j1rie/IRMP_STM32/RP2xxx/LIESMICH.md

## IRMP auf RP2xxx

RP2040-One+TSOP [1]  
IR-Sensor_1
IR-Sensor_2 [2]  

Für Boards mit dem RP2xxx, z.B. den Raspberry Pi Pico, Pico2 und viele andere.  
Dies sind zusätzliche Informationen, grundlegende Informationen unter https://github.com/j1rie/IRMP_STM32/blob/master/LIESMICH.md.

## Firmware flashen
USB Verbindung trennen.
Halten Sie die BOOTSEL-Taste gedrückt und steckenn Sie das Gerät an den USB Anschluss. Das Gerät wird als Massenspeicher angezeigt (USB ID 2e8a:0003).  
Ziehen Sie die Datei firmware.uf2 per Drag & Drop auf den Massenspeicher. Das Gerät wird neu gestartet und startet als IRMP HID Gerät.

Durch das Senden des Befehls „reboot“ wird das Gerät ebenfalls in den Massenspeichermodus versetzt.

Wenn sich bereits eine ältere Firmware auf dem Gerät befindet, versetzt stm32IRconfig - b das Gerät in den Massenspeichermodus, und
picotool load -v -x firmware.uf2 flasht die Firmware, verifiziert und startet sie.

## Motherboard Test
Wenn einer der Einschaltpins an Masse liegt und der andere ca. +3,3 V oder +5 V führt, ist das Motherboard für die folgende einfache Verkabelung geeignet.  
Wenn nicht (sehr selten) braucht man einen Optokoppler.

## Kabel löten und anschließen
Ein 10 cm Dupont-Kabel wird aufgetrennt, die beiden Enden miteinander und dem 220 Ohm Widerstand verbunden, das andere Ende des Widerstands wird mit einem 20 cm Dupont-Kabel, dessen eine Buchse abgeschnitten ist, verbunden. Lötstellen einschrumpfen und das zweite 10 cm Kabel mittels Schrumpfschlauch anheften.  
Der TSOP wird direkt mit den Pins 3,3 V, GND und IR_IN verbunden, das Kabelpaar wird zwischen die Mainboard-Einschaltpins und den Stecker des Einschalters eingeschleift.  

Kabel
verbunden

## Erster Test
Wenn man im Suspend-Modus die BOOTSEL-Taste drückt, sollte der PC aufwachen.

## Emuliertes Eeprom
Jede Konfiguration, die mit einem der Konfigurationsprogramme vorgenommen wird, wird zunächst nur im Cache gespeichert. Um
diese Änderungen dauerhaft im Flash zu speichern, muss ein Eeprom-Commit durchgeführt werden. Dies betrifft Makros und mehrere Wakeups.  
Ausnahme: Der erste wakeup wird aus Gründen der Abwärtskompatibilität von der Firmware übertragen.

## Aus den Quellen bauen
Siehe [Getting Started with the Raspberry Pi Pico](https://rptl.io/pico-get-started)  
-> SDK und die Beispiele herunterladen  
-> Toolchain Installieren  
-> „Blink“ erstellen  
-> „Blink“ hochladen und ausführen  

## Pin-Out
Siehe ./src/config.h.

## 5 V vom Netzteil statt über USB
Wenn das Gerät vom Netzteil versorgt werden muss, darf es nicht zusätzlich über USB versorgt werden, um Querströme zu vermeiden.
Eine Möglichkeit ist es, die Leiterbahn auf dem PCB zu durchtrennen:  

VBUS trennen

## Signale von den LEDs
Der Pico(2) hat eine normale LED, der One und der Zero haben eine RGB LED, und der XIAO-RP2350 hat eine Duale und eine RGBW LED.  
Zusätzlich kann eine externe LED oder externe RGB LED (WS2812 oder APA106) angeschlossen werden.  
Diese zeigen an, was in der Firmware passiert.  
Dann gibt es noch die Status LED (über hidraw angesteuert), die den Status des vdr-plugin-statusleds2irmplirc anzeigt (und beim Einschalten, beim Speichern des ersten Wakeups und bei Reboot blinkt).

| Empfänger |  Board/Externe RGB-LED | Board/Externe LED  | Externe Status-LED |
|---|---|---|---|
| stromlos |  aus | | |
| USB eingehängt |  weiß (oder custom) | | |
| USB suspend |  orange | | |
| IR Empfang |  flackert blau | flackert | |
| Wakeup speichern |  blinkt schnell rot | blinkt schnell | blinkt schnell |
| Wakeup |  blinkt schnell rot | blinkt schnell | blinkt schnell |
| Reboot |  blinkt schnell rot | blinkt schnell | blinkt schnell |
| IR senden |  kurz gelb | kurz an | |
| VDR läuft |  rot(*) | | an(*) |
| VDR nimmt auf |  blinkt rot entsprechend Anzahl Aufnahmen(*) | | blinkt entsprechend Anzahl Aufnahmen(*) |
| Konfigurationsbefehl  |  kurz grün | kurz an | |
| firmware upgrade | | kurz an | kurz an |

(*) mit vdr-plugin-statusleds2irmplirc

## Externe RGB-LEDs
Es wird empfohlen, zwei Widerstände im Datenkabel zu verwenden, siehe http://stefanfrings.de/ws2812/.

##
 \
[1] Waveshare RP2040-One mit TSOP von clausmuus, siehe https://www.vdr-portal.de/forum/index.php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  
[2] Waveshare RP2040-One mit TSOP von FireFly, siehe https://www.vdr-portal.de/forum/index.php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
