j1rie/IRMP_STM32/stm32IRstatusled/README

Set statusled on STM32.
For use in vdr-plugin-statusleds.

Usage:
stm32IRstatusled [-d device] -s led_state

Examples:
switch the statusled on:  stm32IRstatusled -d /dev/hidraw1 -s 1
switch the statusled off: stm32IRstatusled -d /dev/hidraw1 -s 0

put the udev rule from irmplircd into your udev rules directory, then you don't need to give a device

vdr + vdr-plugin-statusleds + stm32IRstatusled:
vdr -P'statusleds --stm32IRstatusled_path=/path/to/stm32IRstatusled'
this will turn the led on, when vdr starts; it will turn the led off, when vdr stops; it will make the led blink during recording
for systemd add a line to the vdr service ExecStop=/path/to/stm32IRstatusled -s 0
