j1rie/IRMP_STM32/doc/README

These are copies of [1], [2] and [3], and those may be more up-to-date.
[1] https://www.mikrocontroller.net/articles/IRMP_auf_STM32_-_ein_USB_IR_Empf%C3%A4nger/Sender/Einschalter_mit_Wakeup-Timer
[2] https://www.mikrocontroller.net/articles/IRMP_auf_STM32_-_Bauanleitung
[3] https://www.mikrocontroller.net/articles/IRMP_auf_STM32_%E2%80%93_stark_vereinfachte_Bauanleitung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
