j1rie/IRMP_STM32/stm32IRconfig/Windows/README

configure and monitor IRMP_STM32

program and read the eeprom (wakeups, macros and capabilities)
reset wakeups, macros, alarm and eeprom
set and get the alarm
reboot the device
send IR
monitor (read) IRMP_STM32, stop with ^C
