j1rie/IRMP_STM32/irmplircd/Gentoo/README

Gentoo integration see https://www.vdr-portal.de/forum/thread/123572-irmp-auf-stm32-ein-usb-ir-empf%C3%A4nger-sender-einschalter-mit-wakeup-timer/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
