j1rie/IRMP_STM32/stm32FWupgrade/Linux/README

IRMP STM32 Firmware Upgrade Utility

very simple tool
in case of problems try dfu-util

disconnect device
run ./stm32FWupgrade ./firmwarefile.bin
connect device

for Windows WinUSB drivers from zadig are needed (see binaries/bootloader/Windows)
