j1rie/IRMP_STM32/vdr-plugin-irmplirc/LIESMICH

Dies ist ein Plugin fuer den Video Disk Recorder (VDR).

Verfasst von:                      Joerg Riechardt <J.Riechardt@gmx.de>

Projekt-Homepage:                  https://github.com/j1rie/IRMP_STM32_KBD/vdr-plugin-irmphidkbd

Aktuelle Version verfuegbar unter: https://github.com/j1rie/IRMP_STM32_KBD/vdr-plugin-irmphidkbd

Beschreibung: Das Plugin irmplirc sendet Tastatureingaben von einem IRMP HID-Geraet an VDR.

Die einfachste Methode zum Erstellen von Tastenbelegungen in remote.conf ist die Verwendung des Tasten-Anlernprozesses von VDR.

irmplircd wird dann nicht mehr gebraucht.

Wenn man das vdr-plugin-softhddevice verwendet, muss die Fernbedienungsfunktion von softhddevice mit -P'softhddevice ... -N' deaktiviert werden.
