j1rie/IRMP_STM32/vdr-plugin-irmplirc/README

This is a "plugin" for the Video Disk Recorder (VDR).

Written by:                  Joerg Riechardt <J.Riechardt@gmx.de>

Project's homepage:          https://github.com/j1rie/IRMP_STM32/vdr-plugin-irmplirc

Latest version available at: https://github.com/j1rie/IRMP_STM32/vdr-plugin-irmplirc

Description: The 'irmplirc' plugin sends keypresses from a IRMP HID-Device to VDR.

The easiest way for creating key mappings in remote.conf is to use VDR's key learning process.

Than irmplircd is not needed any more.

If you use the vdr-plugin-softhddevice, you need to disable softhddevice's remote control function with -P'softhddevice ... -N'.
