j1rie/IRMP_STM32/hardware/Black_jr5_bot.png

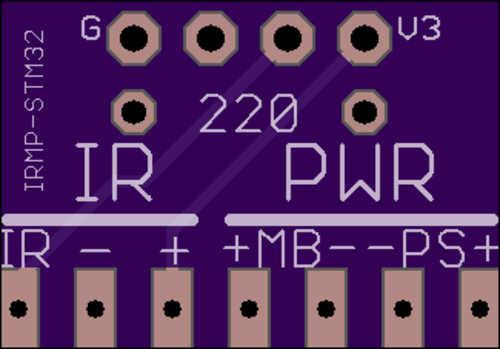
hardware/Black_jr5_bot.png
