j1rie/IRMP_STM32/hardware/Black_OC_jr7_bot.png

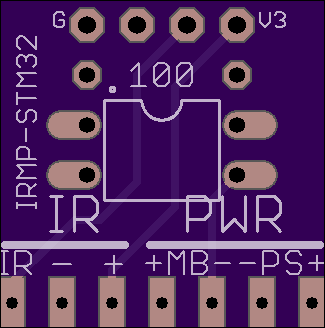
hardware/Black_OC_jr7_bot.png
