j1rie/IRMP_STM32/hardware/Maple_Mini_jr1_bot.png

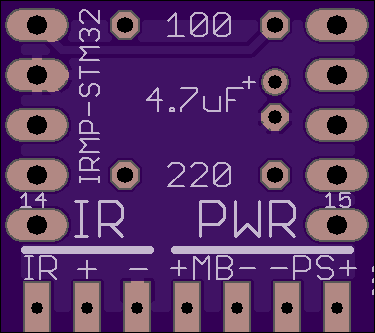
hardware/Maple_Mini_jr1_bot.png
