j1rie/IRMP_STM32/hardware/Maple_Mini_jr1_top.png

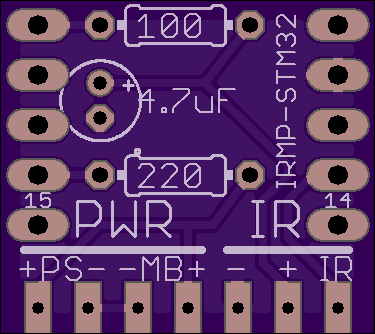
hardware/Maple_Mini_jr1_top.png
