j1rie/IRMP_STM32/hardware/Stick1_jr1_top.png

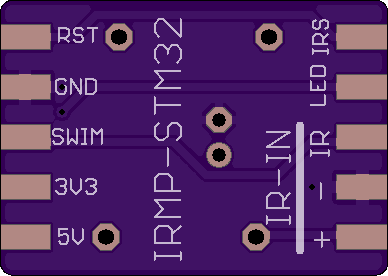
hardware/Stick1_jr1_top.png
