j1rie/IRMP_STM32/hardware/TSOP_jr3_bot.png

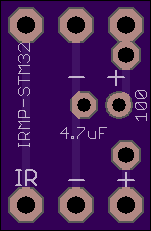
hardware/TSOP_jr3_bot.png
