j1rie/IRMP_STM32/hardware/TSOP_jr3_top.png

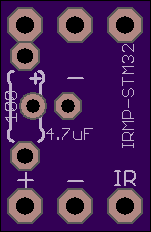
hardware/TSOP_jr3_top.png
