j1rie/IRMP_STM32/hardware/Verbinder_jr1_bot.png

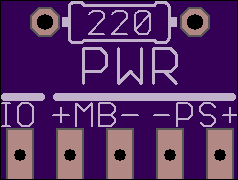
hardware/Verbinder_jr1_bot.png
