j1rie/IRMP_STM32/hardware/Verbinder_jr1_top.png

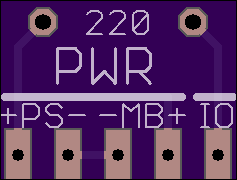
hardware/Verbinder_jr1_top.png
