j1rie/IRMP_STM32/doc/IRMP on STM32 - Construction manual.pdf

## IRMP on STM32 - Construction manual

Copyright (C) 2014-2015 Jörg Riechardt

## Contents

- 17 IRMP on STM32 - Construction manual
- 18 Foreword
- 19 Buy
- 20 Firmware Compilation (Linux)
- 21 Firmware Compilation (Windows)
- 22 Programmer
- 23 Target
- 24 Flashing (Linux)
- 25 Flashing (Windows)
- 26 Connections
- 27 Learning Wakeup
- 28 Testing (Linux)
- 29 Testing (Windows)
- 30 Expansion Board
- 31 Bootloader (Linux)
- 32 Automatic Start/Stop of irmplircd(*) on Re/Disconnect with systemd
- 33 Minimalistic assembly for experienced users

## Foreword

This manual is for two ST-Links. You could use a developer board and a USB-serial-TTL adapter instead. The ST-Links in USB stick cases are wired like red ST-Links.

## Buy

You need two ST-Link V2 emulators.
An ebay search for "ST-Link V2 emulator" shows, what is available.
I bought the red one from seller e_goto for 4.99 $, so ca. 4 €.
The blue ones you get at http://www.aliexpress.com/item/STLINK-V2-STM8-STM32-emulator-programmer-mini-STLINK-downloader/1446941850.html

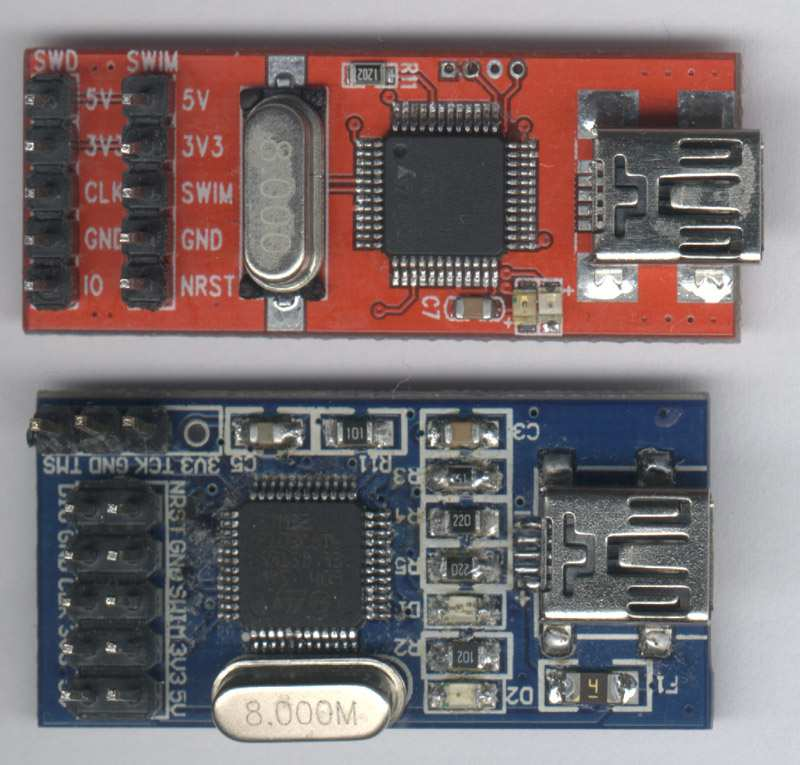
[picture p27: figure]

There are three pins soldered into the blue one for TCK and TMS.
On the blue one CLK and TCK and also DIO and TMS are exchanged.

## Firmware Compilation (Linux)

gcc-arm-none-eabi is needed for compilation. If it is not already available through your distribution, you can get it from https://launchpad.net/gcc-arm-embedded/+download .
git clone git://github.com/j1rie/IRMP_STM32.git IRMP_STM32
cd IRMP_STM32
cd F103
./make

## Firmware Compilation (Windows)

https://github.com/j1rie/IRMP_STM32
download and extract IRMP_STM32-master.zip
run prepare.bat in scripts
open IR.coproj in CooCox and compile

## Programmer

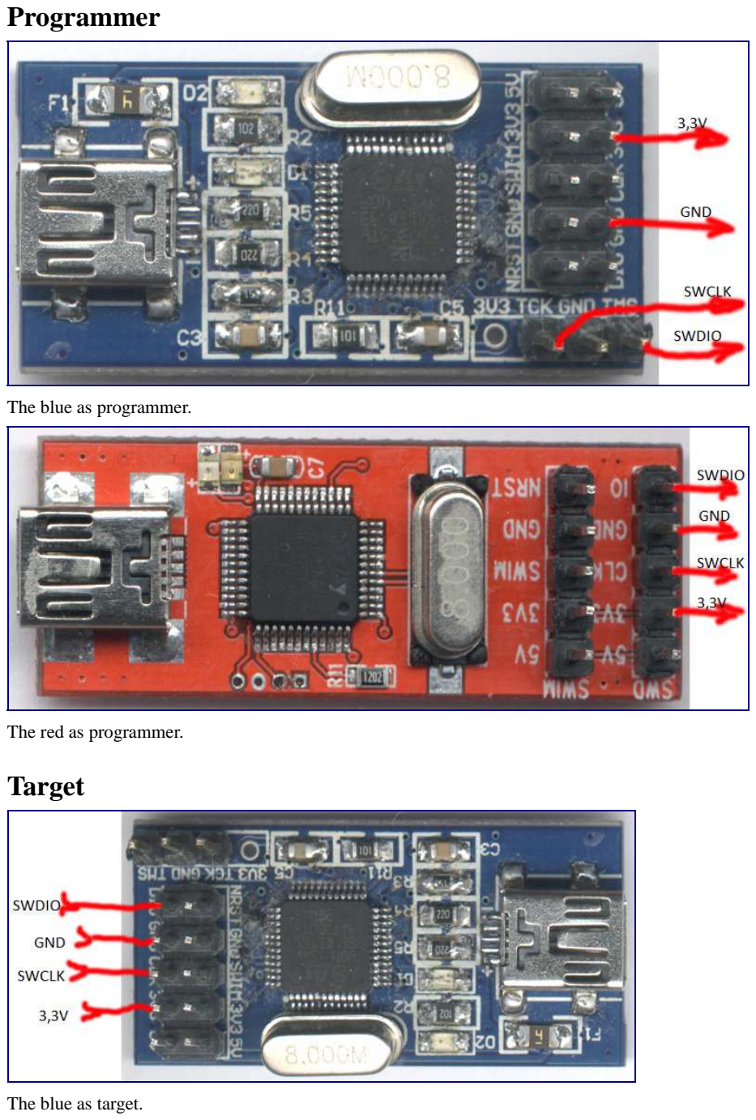
[picture p28: page 3]

The blue as programmer.

The red as programmer.

## Target

The blue as target.

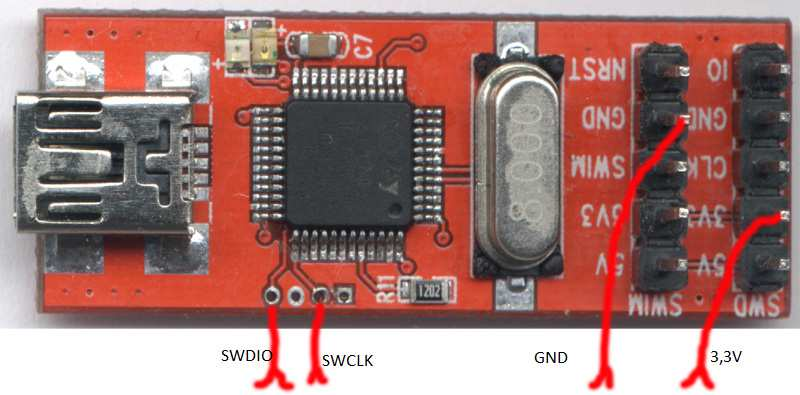
[picture p29: figure]

The red as target.
For the TSOP to work on SWIM, it might be necessary to remove the pullup on SWIM (image below). I have a (very old) TSOP, which does not work with the pullup. But a TSOP 34136 works even with the resistor.

With a red as programmer and a blue as target, you don't need to solder (if you go without the bootloader). Or you could simply press two contact pins against SWDIO und SWCLK during flashing.

## Flashing (Linux)

Connect programmer and target, SWCLK - SWCLK, SWDIO - SWDIO, 3,3V - 3,3V, Gnd -Gnd. You need to unlock the controller before the first flash with an openocd command:
$ openocd -f interface/stlink-v2.cfg -f target/stm32f1x_stlink.cfg -c "init" -c "halt" -c "stm32f1x unlock 0" -c "shutdown"
Then flash the firmware:
git clone git://github.com/texane/stlink.git
cd stlink
./autogen.sh
./configure
./make
./st-flash erase
./st-flash --reset write /IRMP_STM32/F103C8/firmware.bin 0x8000000
In some cases it is necessary, to reset the ST-Link at the beginning of flashing. You need to pull the marked area in the image to ground and release it shortly after the flash command.

## Flashing (Windows)

With the STM32 ST-LINK utility.
Connection and reset as in linux section.
Unlocking: -> Target -> Option Bytes, put Read Out Protection to Disabled. Flashen: -> Target -> Program & Verify

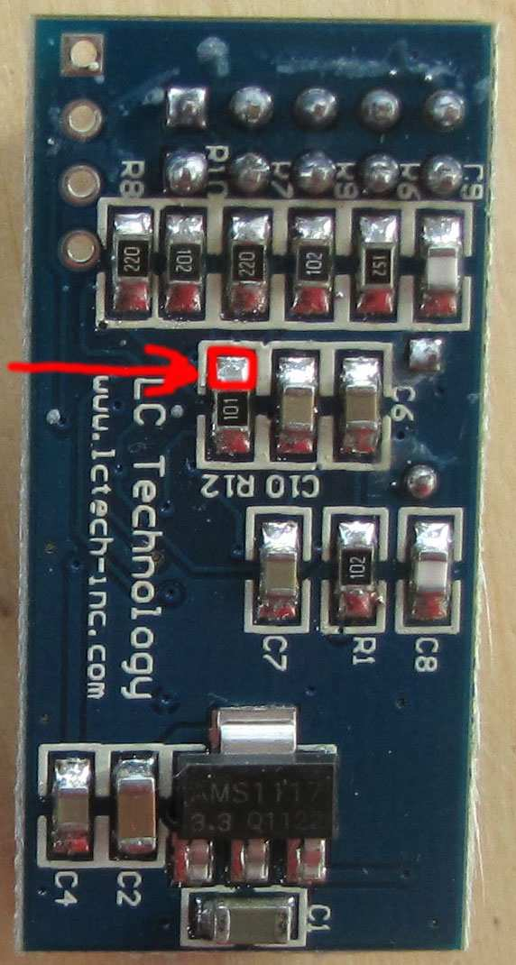
[picture p30: figure]

For reset pull the red marked to ground.

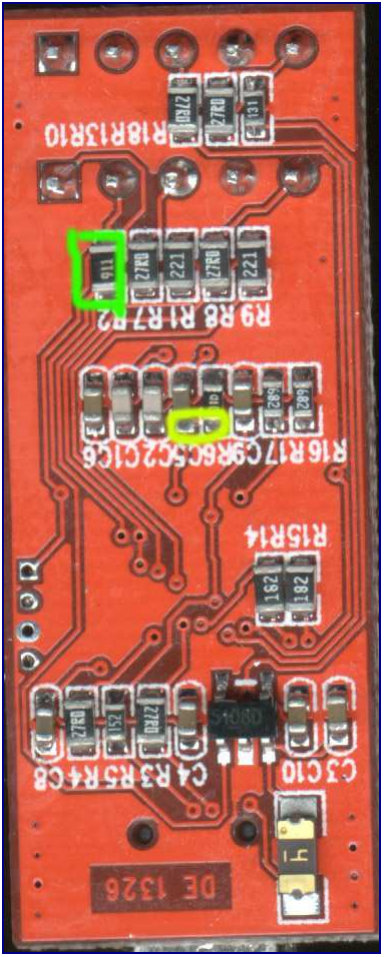
[picture p31: figure]

For reset pull the yellow marked to ground. Green marked the pullup on SWIM.

## Connections

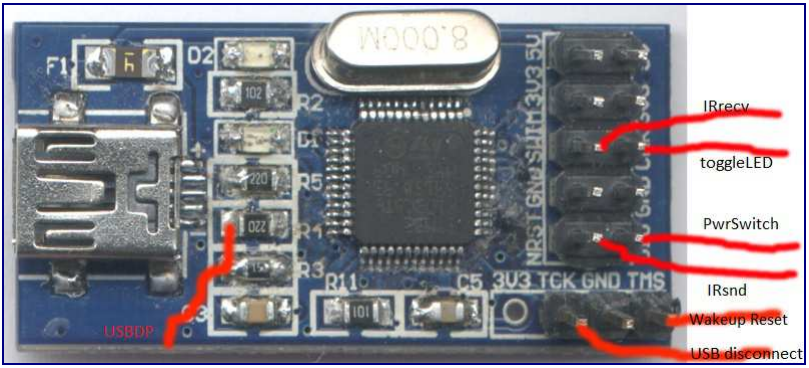
[picture p32: figure]

Connect the blue.

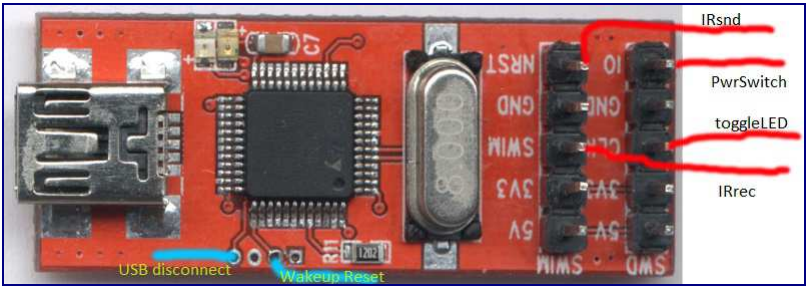
[picture p33: figure]

Connect the red.

## Learning Wakeup

If the first wakeup is empty, the first received IR data will be stored into the first wakeup.
To renew learning pull the wakeup reset pin shortly to ground and push within the next 5 seconds the button, which shall be learned.
You could enter the new wakeup IR data as well manually or via remote control with the configuration program.
If the PC is powered on, the wakeup button does not trigger the optocoupler, but is passed on by irmplircd. If the wakeup button has been trained in VDR as power button, you can power down the PC by it.

## Testing (Linux)

With stm32IRconfig_gui: connect the ST-Link, start stm32IRconfig_gui, press "receive mode" and test.
With stm32IRconfig: connect the ST-Link, start stm32IRconfig, enter m for monitor mode and test. With irmplircd: connect the ST-Link, start irmplircd and irw and test.

Please note: The (D)IO/PwrSwitch-pin switches only, if the PC is powered off.

## Testing (Windows)

With stm32IRconfig_gui: connect the ST-Link, start stm32IRconfig_gui, press "receive mode" and test.
With stm32IRconfig: connect the ST-Link, start stm32IRconfig, enter m for monitor mode and test. With SimpleHIDWrite: connect the ST-Link and select it in SimpleHIDWrite and test. http://janaxelson.com/hidpage.htm#tools
Please note: The (D)IO/PwrSwitch-pin switches only, if the PC is powered off.

## Expansion Board

There is a expansion board. With the connector on one side, it fits onto the blue, and with the connector on the other side it fits onto the red.
Circuit
http://www.vdr-portal.de/board73-marktplatz/board75-verkaufen/p1220193-usb-ir-receiver-inkl-einschalter-opensource-sw-hw/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
It is important, to pay attention to the polarity of the optocoupler. Those contacts, that are closer to IRin, are plus.

## Bootloader (Linux)

git clone -b unify_platforms git://github.com/j1rie/maple-bootloader.git cd maple-bootloader
make Platform=Dev (Developer board) or
make Platform=Red (Red) or
make PPlatform=Blue (Blue)
Then flash ./build/maple_boot.bin.
After that you flash like this:
First run /path/FlashDFUSe.sh /path/newFirmware.bin*, then connect the ST-Link.
(*) The firmware needs to be compiled with Bootloader=1.

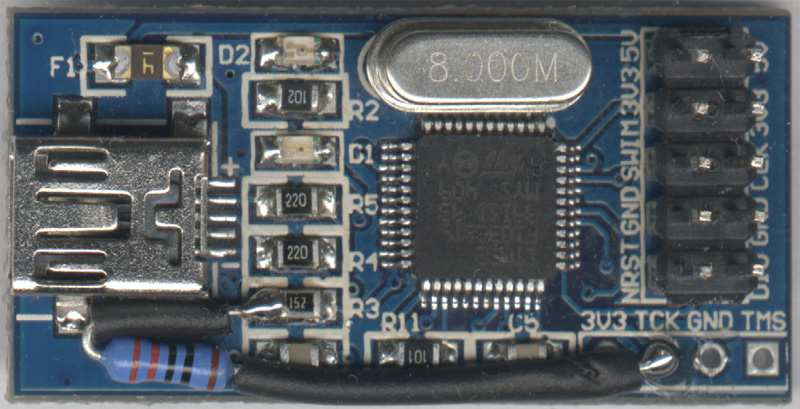
[picture p34: figure]

The blue with pulldown resistor between USBDP and USB disconnect pin.

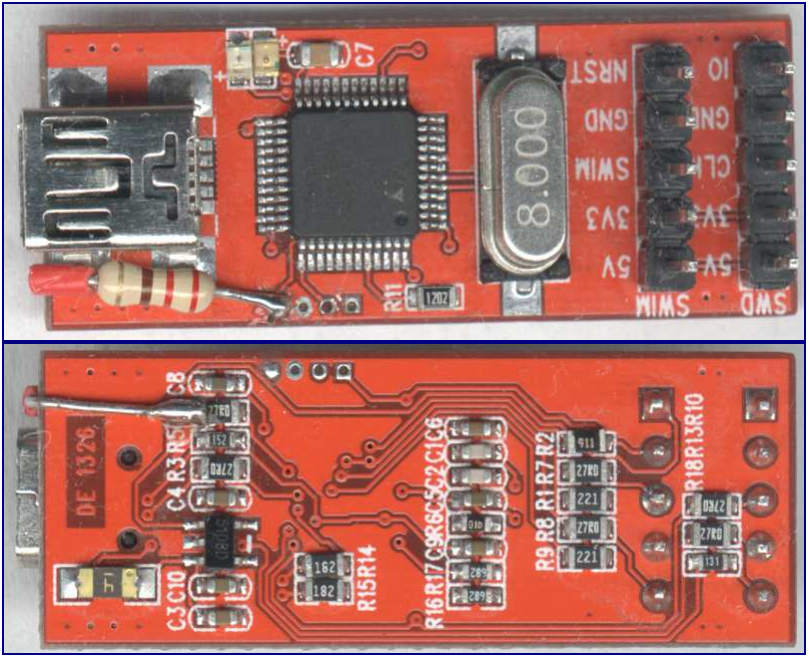
[picture p35: figure]

The red with pulldown resistor between USBDP and USB disconnect pin.

## Automatic Start/Stop of irmplircd(*) on Re/Disconnect with systemd

Copy 80-irmp.rules from IRMP_STM32/irmplircd/ to /etc/udev/rules.d/ .
Copy irmplircd.service from IRMP_STM32/irmplircd/ to /etc/systemd/system/ .
Activate service by 'systemctl enable irmplircd.service'.
Adapt paths to irmplircd and irmp_stm32.map in irmplircd.service if needed.
The translation tabelle irmp_stm32.map can be created and adapted with stm32IRconfig_gui. (*) https://github.com/realglotzi/irmplircd

## Minimalistic assembly for experienced users

Only for IR reception and turning the PC on. The TSOP is directly connected to the corresponding pins and the mainboard's active power switch pin is pulled down via the resistor (220 ohms) (SimpleCircuit = 1).
Please be careful and don't damage your motherboard!
Either directly via the protection resistor to the powerswitch-cable ...

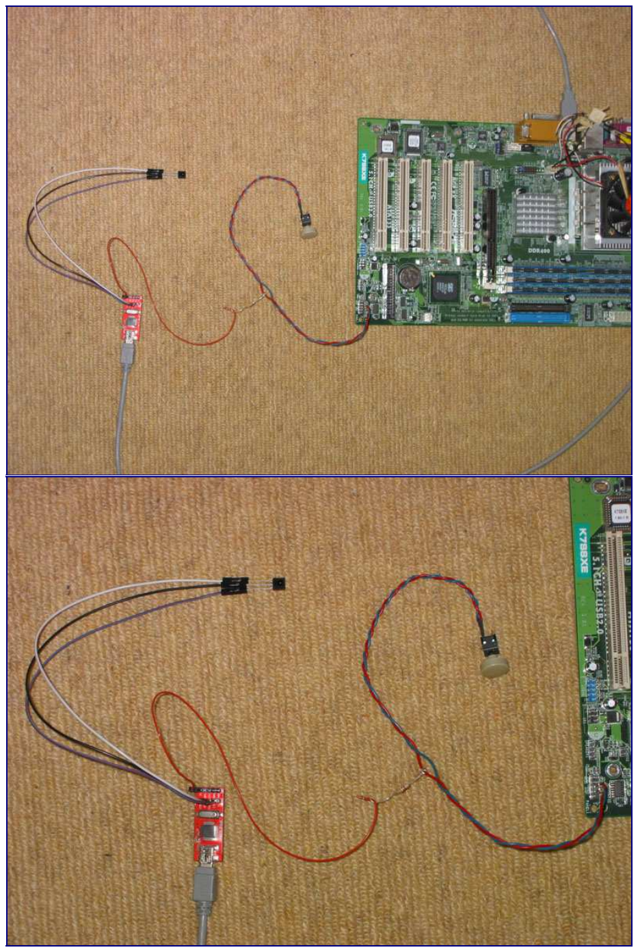
[picture p36: page 10]

… or to an inbetween piece, which gets inserted between board and powerswitch-cable.

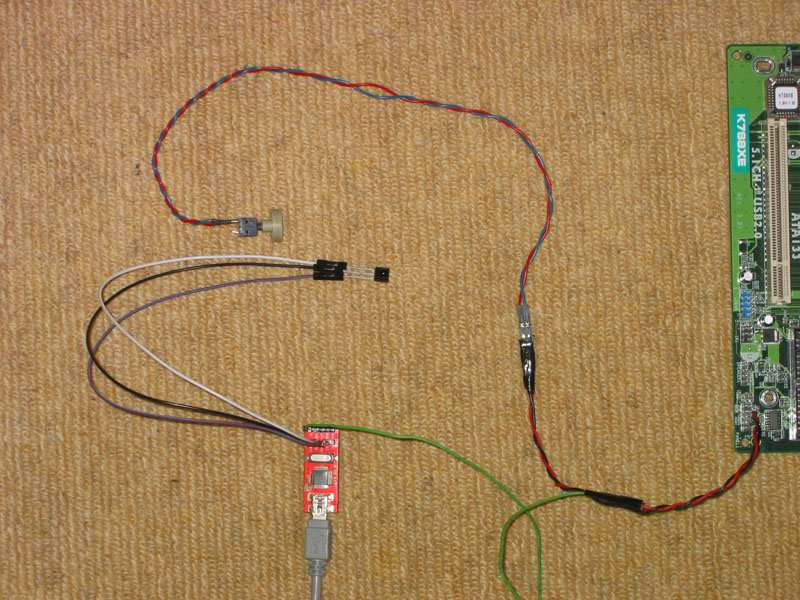
[picture p37: figure]

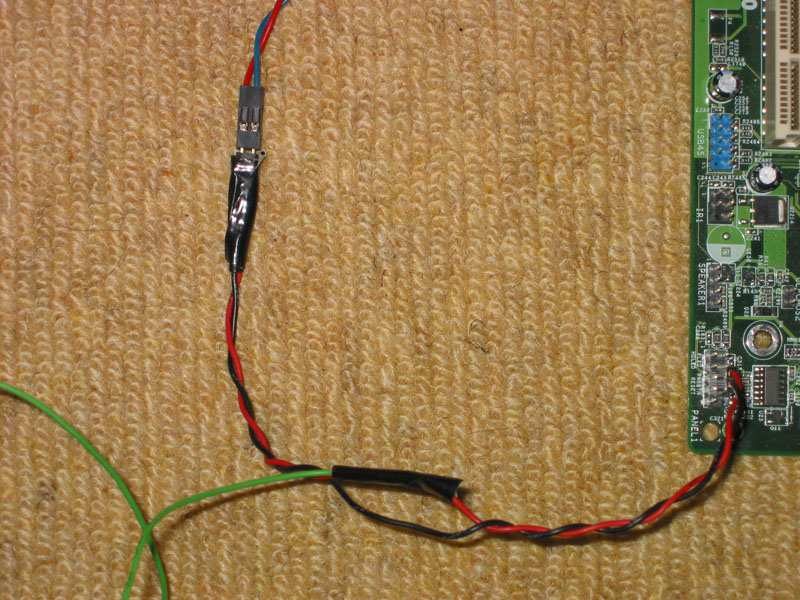
[picture p38: figure]

To check, if it is possible to omit the optocoupler, you can test the powerswitch pins of the mainboard like this.
Measure if one pin is on ground and the other on ca. +3,3V or +5V. Then short-circuit both via a multimeter, and measure the current. It is usually only few mA, and as long as it is below 25 mA, the test is passed.
Perfectionists could connect a high turned pot to both pins, turn it slowly down and measure, since which resistance the board switches on. Then you take a corresponding protection resistor. Otherwise you take 220 ohm, after checking, that the board switches on, when both pins are connected through it. If you are shure to never make a mistake while putting together, you could omit the resistor as well.
Even though this is not done on the pictures for simplicity, it is better to connect the TSOP via a RC element, see http://www.vishay.com/docs/82492/tsop312.pdf .
