j1rie/IRMP_STM32/doc/Deutsch/IRMP auf STM32 – stark vereinfachte Bauanleitung.pdf

# IRMP auf STM32 – stark vereinfachte Bauanleitung

Copyright (C) 2017 Jörg Riechardt

## Vorwort

Diese Anleitung hat das Ziel, den Bau des Empfängers so einfach wie möglich zu machen.
Es sind allerdings für die Pins des Maple Mini und das Einschaltkabel Basis-Lötkenntnisse nötig. Hier nur für IR Empfang und PC Einschalten.

## Kauf

Man braucht

- einen Maple Mini Clone [1], Stichwort für ebay: „ Maple Mini“
- DuPont Steckverbinder weiblich – weiblich, Stichwort: DuPont 20cm female female
- DuPont Steckverbinder weiblich – männlich, Stichwort: DuPont 10cm female male
- TSOP4838 (je nach benötigter Frequenz), Stichwort: TSOP4838
- einen 220 Ohm Widerstand, Stichwort: 220 ohm metal film
[1] http://wiki.stm32duino.com/index.php?title=Maple_Mini

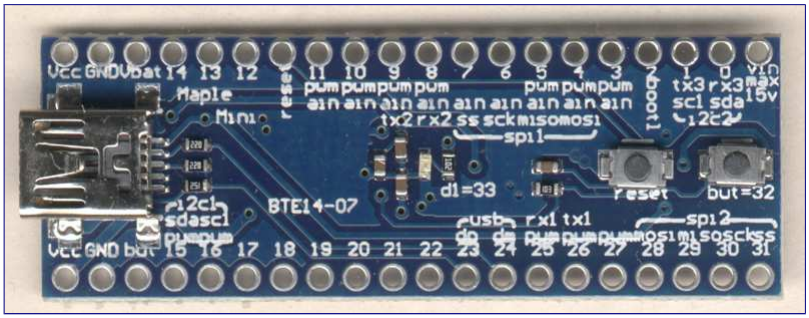
[picture p39: figure]
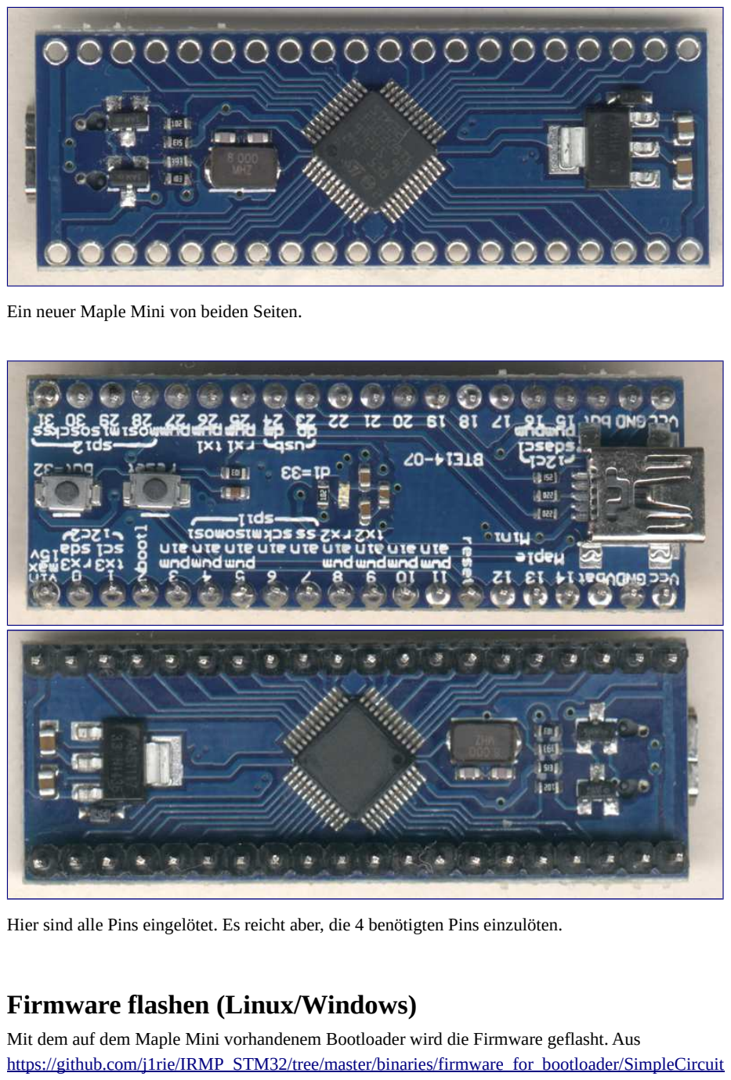
[picture p40: page 2]

Ein neuer Maple Mini von beiden Seiten.

Hier sind alle Pins eingelötet. Es reicht aber, die 4 benötigten Pins einzulöten.

## Firmware flashen (Linux/Windows)

Mit dem auf dem Maple Mini vorhandenem Bootloader wird die Firmware geflasht. Aus https://github.com/j1rie/IRMP_STM32/tree/master/binaries/firmware_for_bootloader/SimpleCircuit die Maple Mini Firmware xxx_MapleMini_SC_BL_jrie.bin holen.
Aus https://github.com/j1rie/IRMP_STM32/tree/master/bootloader FlashDFUSe.sh bzw FlashDFUSe.bat holen.
Auf der Kommandozeile ausführen
- Linux: FlashDFUSe.sh xxx_MapleMini_SC_BL_jrie.bin
- Windows: FlashDFUSe.bat xxx_MapleMini_SC_BL_jrie.bin

und den Maple Mini anstecken.
Am Ende sieht man: Download [=========================] 100%.

## Kabel löten

Ein 10cm Kabel wird aufgetrennt, die beiden Enden miteinander und dem 220 Ohm Widerstand verbunden, das andere Ende des Widerstands wird mit dem 20cm Kabel, dessen eine Buchse abgeschnitten ist, verbunden. Lötstellen einschrumpfen, das andere 10cm Kabel mittels Schrumpfschlauch anheften.

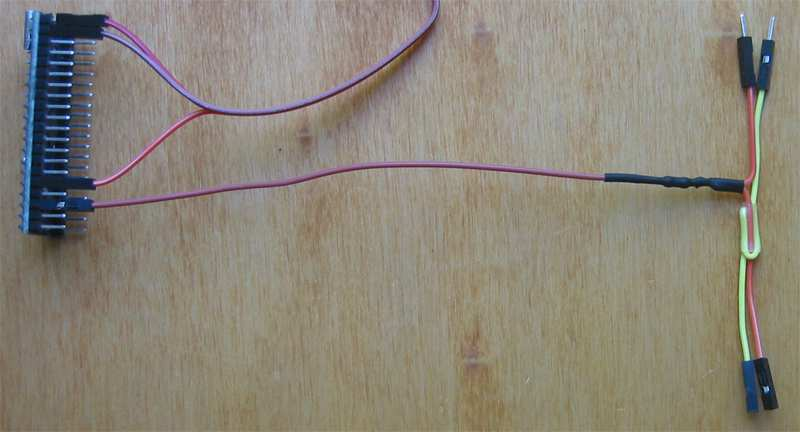
[picture p41: figure]

## Kabel anschließen

Der TSOP ist direkt mit den entsprechenden Pins verbunden, das Kabelpaar wird zwischen die Mainboard-Einschaltpins und den Stecker vom Einschalter eingeschleift und der aktive Einschaltpin des Mainboards wird über den Widerstand (220 Ohm) herunter gezogen.
Einschaltpin = B10 = „1“ ↔ 220 Ohm
IR-in-Pin = B0 = „3“ ↔ TSOP out
„VCC“ ↔ TSOP Vs
„GND“ ↔ TSOP GND

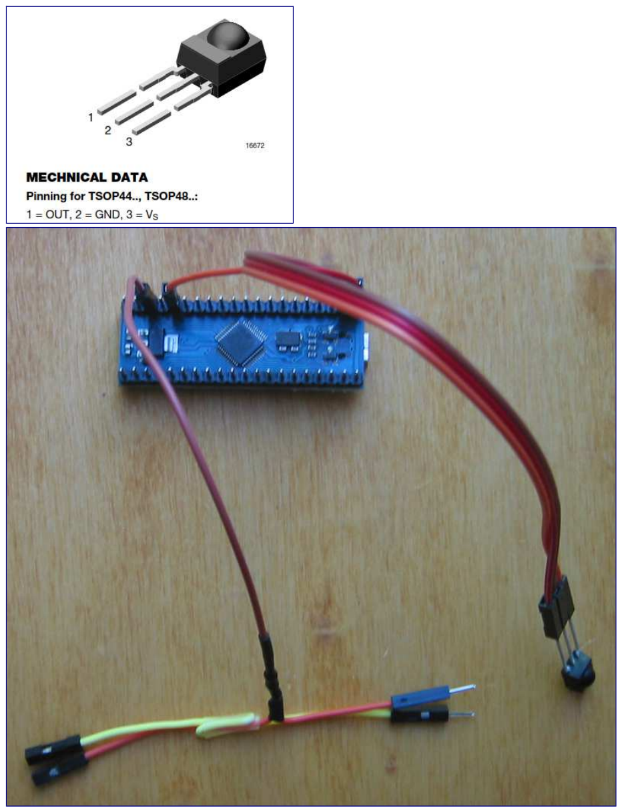
[picture p42: page 4]

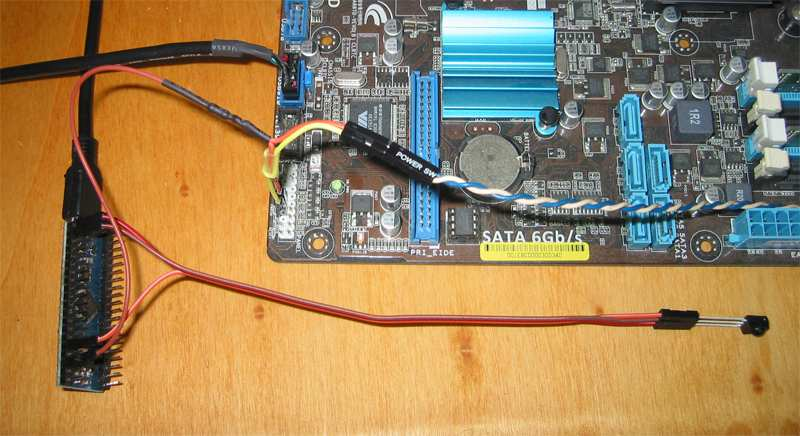
[picture p43: figure]

## Wakeup anlernen

Falls das erste Wakeup leer ist, werden automatisch die ersten empfangenen IR Daten ins erste Wakeup gespeichert.
Man kann die neuen Wakeup IR Daten auch per Fernbedienung mit dem Konfigurationsprogramm eingeben.

## Testen (Linux/Windows)

Windows: Aus
https://github.com/j1rie/IRMP_STM32/tree/master/binaries/stm32IRconfig_gui/Windowsstm32IRconfig_gui.exe holen, Empfänger anschliessen, stm32IRconfig_gui starten, "receive mode" drücken und testen
oder aus https://github.com/j1rie/IRMP_STM32/tree/master/binaries/stm32IRconfig/Windows stm32IRconfig.exe holen, ST-Link anschliessen, stm32IRconfig starten, m eingeben für Monitor-Modus und testen.
EventGhost mit Generic HID unterstützt den Empfänger.
Bitte beachten: Eingeschaltet wird nur, wenn der PC aus ist.
Linux: EasyVDR und yaVDR unterstützen den Empfänger und haben passende Pakete. Sonst muss man selbst bauen.

## Motherboard-Test

Wer prüfen will, ob das Motherboard geeignet ist, macht folgenden Test an den Einschaltpins des Mainboards.
Man misst, ob der eine Pin an Masse liegt und ob der andere ca. +3,3V oder +5V führt. Dann schließt man beide über ein Multimeter kurz, und misst den Strom. Der beträgt üblicherweise nur wenige mA, und solange es unter 25mA sind, ist der Test bestanden. Bisher gab es noch keine Rückmeldung über ein ungeeignetes Board.

## Fertige Empfänger kaufen

Wer nicht löten will:
https://www.vdr-portal.de/forum/index.php?thread/130398-irmp-stm32-usb-ir-empf%C3%A4nger/

## Diskussion

Fragen und Kommentare können hier gestellt werden: http://www.vdr-portal.de/board18-vdrhardware/board13-fernbedienungen/123572-irmp-auf-stm32-ein-usb-ir-empf%C3%A4nger-sendereinschalter-mit-wakeup-timer/
