j1rie/IRMP_STM32/(threads)

Thread 5 (2018-01-01):

Add Standard Peripheral Library Expansion as git submodule (as autobuild currently is broken)

M-Reimer, 2018-01-01:
The "prepare.sh" process currently is broken, so we need some solution to make this project build again.
The best solution to solve this problem would be to add the ST zip file contents to a GIT repository. Then create a new branch in this repository and add our changes to this branch. This way it would be easily possible to update to future library releases by unzipping the new files to the "master" branch and then merge the changes to our "irmp_stm32" branch. The license agreement seems to allow redistribution but just to be sure I've created a support request at st.com.

M-Reimer, 2018-01-01:
My text, I've sent to st.com:

COMM045595: | 045595 - Can we use your Standard Peripheral Library Expansion in our project (GPL2)

We are a small open source project which provides an infrared receiver for remote controls, which can be used on multimedia PCs with Linux or Windows operating system:
https://github.com/j1rie/IRMP_STM32

Our project uses code from your Standard Peripheral Library Expansion. We use parts of the following files:
stsw-stm32010.zip
stsw-stm32121.zip

We've read your license agreement and as far as I understand, redistribution (and so placing files from the above two ZIP files into our project) is allowed as long as we include your license agreement.

We would like to place the contents of the above two ZIP files into a dedicated github repository. We would add your license directly to the root of this repository so it clearly is visible that everything in this repository is covered by your license.

We would link to this repository from our own code using a "git submodule" so our code and ST code is clearly separated.

Would this be legal? Please also allow me to publish your answer as an answer to a github issue on our project.

j1rie, 2020-01-05:
The build process is fixed since long, the libraries we use are no longer updated since ST switched to HAL and ST has not answered, so I guess it is time to close this.

Closed 2020-01-05.
