j1rie/IRMP_STM32/hardware/Black_OC_jr7.brd

## EAGLE design hardware/Black_OC_jr7.brd (2020-02-14)

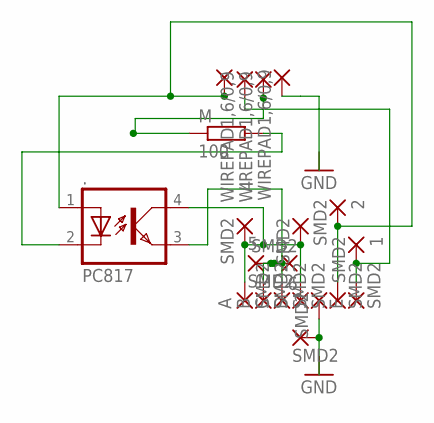
[picture p49: schematic Black_OC_jr7.sch]

Parts:
1, 2, 4, 5, 6, ...: SMD2; SMD1,27-2,54
+: SMD2; SMD1,27-2,54
-: SMD2; SMD1,27-2,54
--: 1,6/0,9
---: WIREPAD1,6/0,9; 1,6/0,9
----: WIREPAD1,6/0,9; 1,6/0,9
-----: WIREPAD1,6/0,9; 1,6/0,9
.: PC817; DIL04
A: SMD2; SMD1,27-2,54
B: SMD2; SMD1,27-2,54
C: SMD2; SMD1,27-2,54
D: SMD2; SMD1,27-2,54
E: SMD2; SMD1,27-2,54
M: 100; 0204/7
PAD7: SMD2; SMD1,27-2,54

Connections:
GND: -.1, -----.1, PAD7.1
unnamed: ----.1, M.1
unnamed: 4.1, ..4 (COL), ....1, A.1, D.1
unnamed: 5.1, 6.1, ..3 (EMIT), B.1, C.1
unnamed: 2.1, +.1, --.1, ..1 (A)
unnamed: 1.1, ---.1, E.1
unnamed: ..2 (C), M.2

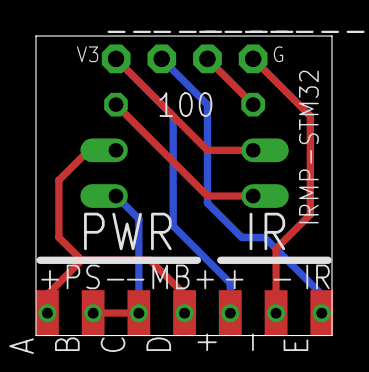
[picture p50: board Black_OC_jr7.brd from above]

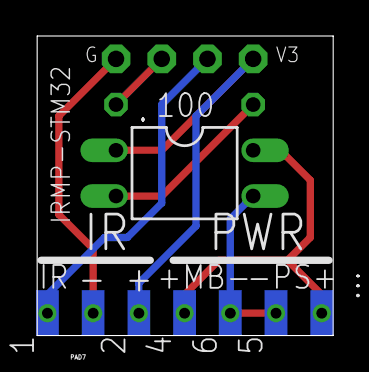
[picture p51: board Black_OC_jr7.brd from below]

Board: 2 copper layers, 16.4 x 16.6 mm, 20 parts (8 on the bottom side), 7 nets.
