j1rie/IRMP_STM32/hardware/TSOP_jr3.brd

## EAGLE design hardware/TSOP_jr3.brd (2020-02-14)

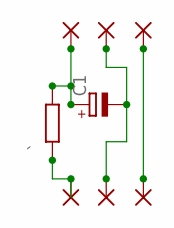
[picture p52: schematic TSOP_jr3.sch]

Parts:
": 1,6/0,9
"": 1,6/0,9
""": 1,6/0,9
...., ....., ......: 1,6/0,9
C1: CPOL-EUE1.8-4; E1,8-4
`: R-EU_0204/5; 0204/5

Connections:
unnamed: ".1, .......1
unnamed: "".1, ......1, C1.-
unnamed: """.1, C1.+, `.2
unnamed: .....1, `.1

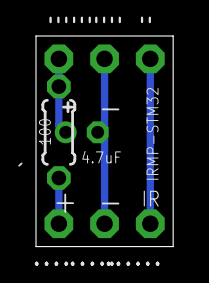
[picture p53: board TSOP_jr3.brd from above]

Board: 2 copper layers, 7.6 x 11.7 mm, 8 parts (0 on the bottom side), 4 nets.
