j1rie/IRMP_STM32/hardware/Verbinder_jr1.brd

## EAGLE design hardware/Verbinder_jr1.brd (2020-02-08)

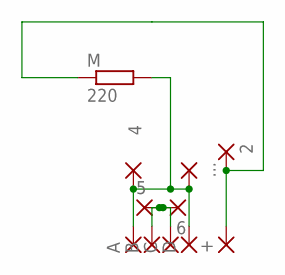
[picture p54: schematic Verbinder_jr1.sch]

Parts:
2, 4, 5, 6, ...: SMD2; SMD1,27-2,54
+: SMD2; SMD1,27-2,54
A: SMD2; SMD1,27-2,54
B: SMD2; SMD1,27-2,54
C: SMD2; SMD1,27-2,54
D: SMD2; SMD1,27-2,54
M: 220; 0204/7

Connections:
unnamed: 2.1, +.1, M.1
unnamed: 4.1, ....1, A.1, D.1, M.2
unnamed: 5.1, 6.1, B.1, C.1

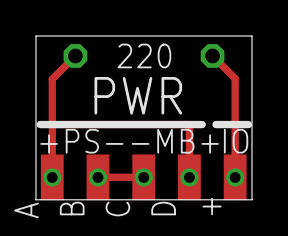
[picture p55: board Verbinder_jr1.brd from above]

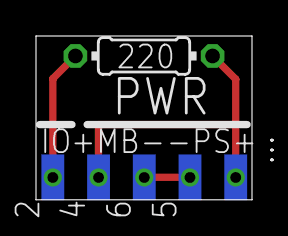
[picture p56: board Verbinder_jr1.brd from below]

Board: 2 copper layers, 12.0 x 9.1 mm, 11 parts (6 on the bottom side), 3 nets.
