j1rie/IRMP_STM32/hardware/Maple_Mini_jr1.brd

## EAGLE design hardware/Maple_Mini_jr1.brd (2018-08-03)

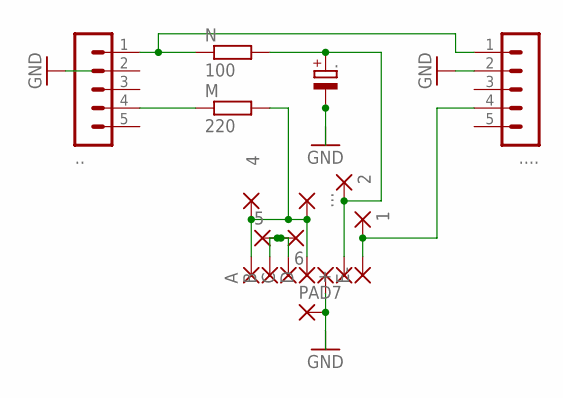
[picture p57: schematic Maple_Mini_jr1.sch]

Parts:
1, 2, 4, 5, 6, ...: SMD2; SMD1,27-2,54
+: SMD2; SMD1,27-2,54
-: SMD2; SMD1,27-2,54
.: CPOL-EUE1.8-4; E1,8-4
.., ....: MA05-1
A: SMD2; SMD1,27-2,54
B: SMD2; SMD1,27-2,54
C: SMD2; SMD1,27-2,54
D: SMD2; SMD1,27-2,54
E: SMD2; SMD1,27-2,54
M: 220; 0204/7
N: 100; 0204/7
PAD7: SMD2; SMD1,27-2,54

Connections:
GND: -.1, ..-, .....2, PAD7.1
unnamed: ...1, .....1, N.1
unnamed: ...4, M.1
unnamed: 4.1, ....1, A.1, D.1, M.2
unnamed: 5.1, 6.1, B.1, C.1
unnamed: 2.1, +.1, ..+, N.2
unnamed: 1.1, .....4, E.1

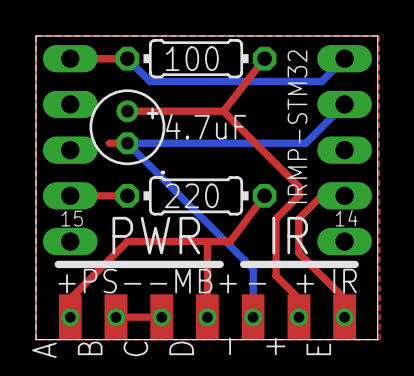
[picture p58: board Maple_Mini_jr1.brd from above]

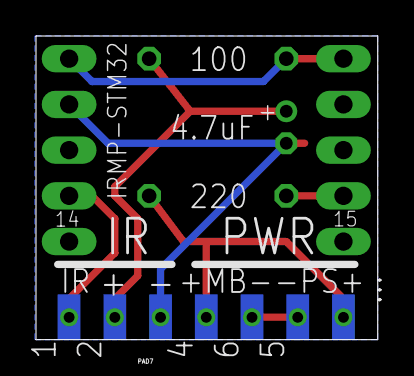
[picture p59: board Maple_Mini_jr1.brd from below]

Board: 2 copper layers, 19.0 x 16.9 mm, 19 parts (7 on the bottom side), 7 nets.
