j1rie/IRMP_STM32/hardware/Stick1_jr1.brd

## EAGLE design hardware/Stick1_jr1.brd (2018-05-05)

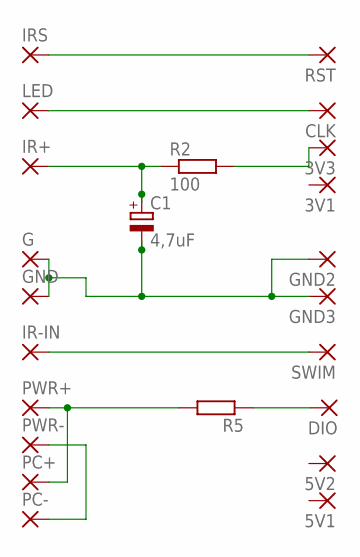
[picture p60: schematic Stick1_jr1.sch]

Parts:
3V1, 3V3, 5V1, 5V2: SMD2; SMD1,27-2,54
C1: 4,7uF; E1,8-4
CLK: SMD2; SMD1,27-2,54
DIO: SMD2; SMD1,27-2,54
G: SMD2; SMD1,27-2,54
GND, GND2, GND3: SMD2; SMD1,27-2,54
IR+: SMD2; SMD1,27-2,54
IR-IN: SMD2; SMD1,27-2,54
IRS: SMD2; SMD1,27-2,54
LED: SMD2; SMD1,27-2,54
PC+: SMD2; SMD1,27-2,54
PC-: SMD2; SMD1,27-2,54
PWR+: SMD2; SMD1,27-2,54
PWR-: SMD2; SMD1,27-2,54
R2: 100; 0204/7
R5: R-EU_0204/7; 0204/7
RST: SMD2; SMD1,27-2,54
SWIM: SMD2; SMD1,27-2,54

Connections:
unnamed: 3V3.1, R2.2
unnamed: C1.+, IR+.1, R2.1
unnamed: PC-.1, PWR-.1
unnamed: PC+.1, PWR+.1, R5.2
unnamed: DIO.1, R5.1
unnamed: CLK.1, LED.1
unnamed: IRS.1, RST.1
unnamed: IR-IN.1, SWIM.1
unnamed: C1.-, G.1, GND.1, GND2.1, GND3.1

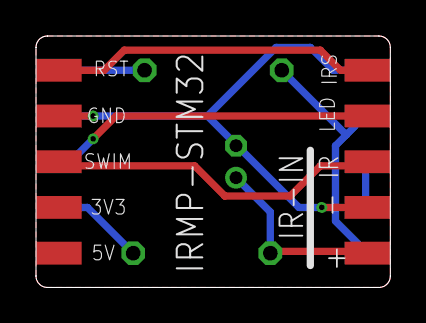
[picture p61: board Stick1_jr1.brd from above]

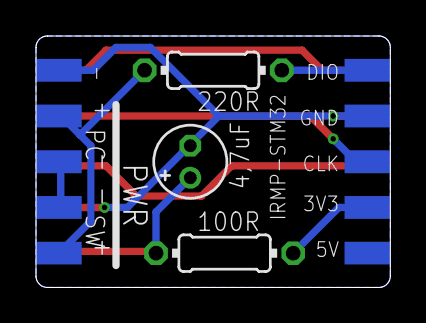
[picture p62: board Stick1_jr1.brd from below]

Board: 2 copper layers, 19.7 x 14.0 mm, 23 parts (13 on the bottom side), 9 nets.
