j1rie/IRMP_STM32/STM32F103xC/src/irmpmain.c

/*
 *  Copyright (C) 2014-2015 Joerg Riechardt
 *
 *  Copyright (c) 2009-2015 Frank Meyer - frank(at)fli4l.de
 *
 *  This program is free software; you can redistribute it and/or modify
 *  it under the terms of the GNU General Public License as published by
 *  the Free Software Foundation; either version 2 of the License, or
 *  (at your option) any later version.
 */
#include "irmpmain.h"

uint32_t SysCtlClockGet(void)
{
	RCC_ClocksTypeDef RCC_ClocksStatus;
	RCC_GetClocksFreq(&RCC_ClocksStatus);
	return RCC_ClocksStatus.SYSCLK_Frequency;
}

/* initialize timer and interrupt */
void IRMP_Init(void)
{

	TIM_TimeBaseInitTypeDef TIM_TimeBaseStructure;
	NVIC_InitTypeDef NVIC_InitStructure;
	RCC_APB1PeriphClockCmd(RCC_APB1Periph_TIM2, ENABLE);

	TIM_TimeBaseStructure.TIM_ClockDivision = TIM_CKD_DIV1;
	TIM_TimeBaseStructure.TIM_CounterMode = TIM_CounterMode_Up;
	TIM_TimeBaseStructure.TIM_Period = 7;
	TIM_TimeBaseStructure.TIM_Prescaler = ((F_CPU / F_INTERRUPTS)/8) - 1;
	TIM_TimeBaseInit(TIM2, &TIM_TimeBaseStructure);

	TIM_ITConfig(TIM2, TIM_IT_Update, ENABLE);

	NVIC_InitStructure.NVIC_IRQChannel = TIM2_IRQn;
	NVIC_InitStructure.NVIC_IRQChannelCmd = ENABLE;
	NVIC_InitStructure.NVIC_IRQChannelPreemptionPriority = 0x0F;
	NVIC_InitStructure.NVIC_IRQChannelSubPriority = 0x0F;
	NVIC_Init(&NVIC_InitStructure);

	TIM_Cmd(TIM2, ENABLE);

	irmp_init();
}

void TIM2_IRQHandler(void)
{
	TIM_ClearITPendingBit(TIM2, TIM_IT_Update);
	if (! irsnd_ISR()) { /* call irsnd ISR */
		irmp_ISR(); /* if not busy call irmp ISR */
	}
}
