j1rie/IRMP_STM32/STM32F103x8/src/irmpmain.h

#ifndef __IRMPMAIN_H
#define __IRMPMAIN_H

#include "irmp.h"
#include "irsnd.h"

#define INV_F_INT_US (1000000 / F_INTERRUPTS)

void IRMP_Init(void);
uint32_t SysCtlClockGet(void);

#endif /* __IRMPMAIN_H */
