j1rie/IRMP_STM32/RP2xxx/src/ws2812.h

/**
 * Copyright (c) 2020 Raspberry Pi (Trading) Ltd.
 *
 * SPDX-License-Identifier: BSD-3-Clause
 */

#include "ws2812.pio.h"
inline void put_pixel(uint8_t red, uint8_t green, uint8_t blue) {
    pio_sm_put_blocking(pio0, 0, (uint32_t)(green << 24 | red << 16 | blue << 8)); // WS2812 is GRB
    pio_sm_put_blocking(pio1, 0, (uint32_t)(red << 24 | green << 16 | blue << 8)); // APA106 is RGB
}
void ws2812_init();
