j1rie/IRMP_STM32/STM32F103xC/src/romtable.c

/*
 Copyright (C) 2020 Joerg Riechardt

 File:		main.c
 License: 	MIT

 Copyright (c) 2020 André van Schoubroeck

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
 THE SOFTWARE IS PROVIDED "AS IS", WITHOUT WARRANTY OF ANY KIND, EXPRESS OR
 IMPLIED, INCLUDING BUT NOT LIMITED TO THE WARRANTIES OF MERCHANTABILITY,
 FITNESS FOR A PARTICULAR PURPOSE AND NONINFRINGEMENT. IN NO EVENT SHALL THE
 AUTHORS OR COPYRIGHT HOLDERS BE LIABLE FOR ANY CLAIM, DAMAGES OR OTHER
 LIABILITY, WHETHER IN AN ACTION OF CONTRACT, TORT OR OTHERWISE, ARISING FROM,
 OUT OF OR IN CONNECTION WITH THE SOFTWARE OR THE USE OR OTHER DEALINGS IN THE
 SOFTWARE.
 */

#include <stdio.h>
#include "stm32f10x.h"
#include "romtable.h"

char rt[8];

void parse_romtable() {
	// ARM v7-M Architecture Reference Manual D1.1 and C1.2.2: peripheral ID at offset 0xFD0, ETM at offset 0x14
	// STM32 Reference manual RM0008 31.6.4: romtable base at  0xE00FF000
	uint8_t continuation_code = (*(int*)(0xE00FFFD0)) & 0x0F;
	uint8_t etm = (*(int*)(0xE00FF014)) & 0x01;

	char *prob = "Unknown";
	if (continuation_code == 0)
		prob = "STM32";
	if (continuation_code == 7)
		prob = "GD32";
	if (continuation_code == 4) {
		if (etm) {
			prob = "CS32";
		} else {
			prob = "APM32";
		}
	}
	if (continuation_code == 5) {
		prob = "HK32";
	}

	sprintf(rt, "%s", prob);
}
