j1rie/IRMP_STM32/(commit log)

2014-11-27 STM32F103 patches, sources and config programs
2014-11-28 STM32F105 patches and sources
2014-11-28 linker-script, prepare.sh and Makefile from STM32F103 and CooCox project file
2014-11-28 add missing brackets by https://github.com/olebowle
    [main.c]
2014-11-30 improve eeprom_read error handling
    [main.c]
2014-11-30 F105: correct startup.patch, update .gitignore, update main.c
    [main.c]
2014-12-11 remove strange bugfix cleanup
    [main.c]
2014-12-12 use same timer for irmp and irsnd remove enable_ir_receiver cleanup don't send macro below MIN_REPEATS
2014-12-13 update F103 to F105 found strange bug in set_handler move toggle_LED out of #ifdef ST_Link reduce delay signal yellow for transmit
    [config.h, irmpmain.c, irmpmain.h, main.c, st_link.c, st_link.h]
2014-12-24 defuse strange problem prepare wakeup reset for ST-Links eeprom_restore returns errors rename st_link.{c,h}
    [config.h, main.c, st_link_leds.c, st_link_leds.h]
2014-12-24 implement CAPS in stm32IRconfig
2015-01-10 automatic sync of supported_protocols, suggested by Michael Kipp F105: adapt port and pin defines to F103
2015-01-19 edit README add bootloader patches for developer board and blue ST-Link emulator with remapping
2015-01-20 move toggle_LED() to main simlify and adapt defines to always wakeup reset if empty learn first wakeup from first received IR data bootloader adaptations
    [config.h, main.c, st_link_leds.c, st_link_leds.h]
2015-01-21 start with wakeup switch off, remove bugfixes
    [main.c]
2015-01-22 refine defines reorder ST-Link LED functions
2015-01-27 ST-Link LEDs always on adapt to new IRMP version
2015-02-18 binaries: firmware for developer board without bootloader added
2015-02-21 remove the 5k stuff, does not work :-(
    [config.h, main.c]
2015-02-26 simplify first setting of USB_DISC pin
2015-03-04 automatic device recognition in stm32IRalarm, stm32IRconfig and irmplircd
2015-05-01 Added "SimpleCircuit" mode to drive power button directly
2015-05-08 stm32IRconfig{_gui} for Windows, binaries too
2015-05-12 added stm32IRalarm for Windows, stm32IRconfig_gui with fox-1.7.51, improvements
2015-05-14 Make it possible to only trigger power button to start the system
2015-05-19 only reset alarm, if it was zero
    [main.c]
2015-05-19 reset alarm, if host not running, too
    [main.c]
2015-05-19 reverted SOF_Callback for F105
    [main.c]
2015-05-22 again SOF callback for F105, actually it was ok already, just does not work with hidapi tools :-( after selecting in SimpleHIDWrite, hidapi tools work too
    [main.c]
2015-05-22 defuse warning, resistor value
2015-05-23 small fixes and debug
    [main.c]
2015-06-04 new VID 0x1209 PID 0x4444 from pid.codes
2016-08-06 adapt irmp.patch for current IRMP
2017-01-19 added USB reset via PA12, Maple Mini, Reset, example map files, binaries
    [config.h, main.c]
2017-01-24 added bootloader for blue developer board
2017-01-25 correct mistake in Make.config.template
    [config.h]
2017-02-03 adapt to Maple Mini addon board, add Maple Mini linker script
2017-02-07 attention with Pin B8 on Maple Mini! prepare for more boards
2017-02-08 refine port defines, added black developer board, fast toggle for all boards, more bootloaders
2017-02-17 USB reset for F105, F105 binaries, ...
    [config.h, main.c]
2017-03-02 blink on IR send, fix IR.Bootloader.coproj, Simple_Circuit_F105, adapt to new bootloader, transfer from F103 to F105
    [config.h, main.c, st_link_leds.c]
2017-04-14 make counter volatile (necessary for new gcc), remove systicks2, corrections for ST-Link USB sticks, correct count in SysTick_Handler(), F105 was SimpleCircuit already due to circuits on board
    [config.h, main.c, st_link_leds.c, st_link_leds.h]
2017-04-21 support for Maple Mini without bootloader and with bootloader with 2k offset, more protocols in supported_protocols[], support printf() via SWO (works only without bootloader), corrections
    [config.h, main.c]
2017-04-25 F105: switch to STM32_USB-Host-Device_Lib_V2.2.0, transfer from F103
2017-09-13 black developer board test (B7,B8)
2017-09-15 clear reset flags, needed for bootloader switch after reset
    [main.c]
2017-09-19 added reboot µC, undone clear reset flags, added nano.specs
    [main.c]
2017-09-20 added button for reboot device, build for windows now with MSYS2 and mingw64
2017-09-23 stm32IRconfig: added reboot device, build for windows now with MSYS2 and mingw64, stm32IRconfig_gui: added doubleclick connects device
2017-09-27 reset USB for F105, new firmware binaries
    [main.c]
2017-10-24 boot_flag conveys information from firmware to new bootloader across reboot
    [main.c]
2017-10-25 also for reboot from stm32IRconfig
    [main.c]
2018-01-05 external LED, short flash instead of toggle, if PC was powered on by firmware send a message
    [config.h, main.c, st_link_leds.c]
2018-01-05 transfer to F105, some minor fixes
    [config.h, main.c, st_link_leds.c]
2018-01-06 pin names, cleanup
2018-01-17 switch to using lircd-uinput (having fixed lircd-uinput) and eventlircd
2018-01-17 switch from BindsTo to Requisite in order to avoid boot delay if receiver is not present
2018-02-19 avoid getting old IR Data, revert initialization of buf
    [main.c]
2018-02-20 null flags before putting into eeprom, reduce short flash duration, cleanup
    [main.c, st_link_leds.h]
2018-02-20 check_* only for first key press, switch to shortflash instead of toggle and to irmp callback
    [main.c]
2018-02-20 further cleanups, revert deleted to much
    [config.h, main.c]
2018-02-20 led_callback also for active low boards, new firmwares
2018-02-23 next step from toggle to blink, store first wakeup if reset too and during runtime also, simplify led_callback
    [main.c, st_link_leds.c]
2018-03-09 add file extension .map if filter is *.map and no extension .map yet
2018-03-09 new binary stm32IRconfig_gui.exe
2018-03-09 new binary stm32IRconfig_gui.exe 32bit
2018-03-13 new function 'write IR', remove apply button, only quit or open if saved or confirmed, don't delete Key after append, remove scancodes from irmp.map and add help text
2018-03-13 binary stm32IRconfig_gui.exe, remove scancodes from irmp_stm32.map
2018-04-03 new binary stm32IRconfig_gui.exe + libwinpthread-1.dll
2018-04-04 stm32IRconfig_gui-Linux: switch from libusb to libudev in order to not kill /dev/hidraw*
2018-04-05 usb stuff no longer needed after switch to hidapi-hidraw
2018-04-05 use dynamic device permissions
2018-05-05 extension board for certain sticks
    [Stick1_jr1.brd, Stick1_jr1.sch]
2018-05-05 pictures for extension board for certain sticks
2018-05-05 added Maple Mini with extension board
2018-06-07 adapt comment, pin numbers
2018-06-09 added Maple Mini 5k with extension board
2018-07-24 thanks for the extension boards
2018-08-03 Maple Mini extension board
    [Maple_Mini_jr1.brd, Maple_Mini_jr1.sch]
2018-08-07 small fixes in supported_protocols[], RCMM firmwares
    [main.c]
2018-08-28 small fixes in text
    [config.h, main.c]
2019-07-13 stm32IRconfig_gui Windows binary
2019-09-26 some boards do need optocouplers
2019-11-08 add ST-Link USB stick with unconnected PB11, fix typo, transfer to F105
    [config.h, main.c]
2020-02-08 added connector board
    [Verbinder_jr1.brd, Verbinder_jr1.sch]
2020-02-14 extension boards, tell which uC from romtable, adapt config tools, minor fixes
    [Black_OC_jr7.brd, Black_OC_jr7.sch, Black_jr5.brd, Black_jr5.sch, TSOP_jr3.brd, TSOP_jr3.sch]
2020-02-14 change blueDev pinout to blackdev pinout, firmwares, fix indentation
    [config.h, main.c]
2020-02-26 warn, if no STM32
2020-03-04 fix error loop, when device gets disconnected, transfer to Windows, binaries
2020-04-25 include libusb-0, dis/enable button, helptext
2020-05-01 use symbolic constants in report descriptor, respond to configuration report ID only, fix endless loop in case device does not answer
    [dfu.c, dfu.h, main.c, stm32mem.c, stm32mem.h]
2020-05-01 change to USB-FS-Device_Lib_V4.1.0: adapt patches and script
2020-05-01 get wTransferSize from device instead from firmwae string
2020-05-09 pointer argument for Upgrade needs to live longer, start thread earlier, initialize Upgrade, cleanup
2020-05-20 stm32IRconfig_gui binary
2020-05-20 tell used gcc-arm-none-eabi version, silence warning
2020-05-21 workaround for https://gcc.gnu.org/bugzilla/show_bug.cgi?id=83967, now newer gcc-arm-none-eabi versions do work
2020-05-21 initial start of stm32FWupgrade with files from @blacksphere/blackmagic/upgrade fetched Feb. 7, 2017
2020-05-21 change from libusb-0.1 to libusb-1.0, get wTransferSize from device, wait for device, firmwarefile as argument, remove -O0 and -MD from Makefile, remove unneeded includes
2020-05-21 stm32FWupgrade for Linux
2020-05-22 binaries: stm32FWupgrade.exe, USB drivers for bootloader
2020-05-23 make upgrade robust: error handling, free after use
    [main.c]
2020-05-27 more simplify as bootloader is known, don't leak libusb_devices
    [main.c]
2020-06-03 stm32config: reset variables on get caps, handle legacy firmware strings, simplify, loop after reboot, gui: sleep longer in Write_and_Check()
2020-06-11 loop 5 s in Write_and_Check(), needed for 'set by remote'; firmware upgrade button always enabled
2020-06-11 README: stm32FWupgrade, stm32IRconfig_gui
2020-06-14 extension boards, tell which uC from romtable thanks to @a-v-s, adapt config tools, minor fixes
    [Black_OC_jr7.brd, Black_OC_jr7.sch, Black_jr5.brd, Black_jr5.sch, TSOP_jr3.brd, TSOP_jr3.sch]
2020-06-17 no longer output whole romtable, simplify uC detection, only one char array for firmware, more fclose and free, small fixes
    [main.c, romtable.c]
2020-06-24 firmwares, use sizeof(rt) instead of fixed size
    [main.c]
2020-07-09 adapt IR.Bootloader.coproj to new gcc-arm-none-eabi versions
2020-07-09 bigger buffer for flashing ZEROS, avoid error in case of device without firmware
2020-07-09 bigger buffer for flashing ZEROS, avoid error in case of device without firmware for Linux as well
2020-07-16 F105: switch to USB On-The-Go Host and Device Lib V2.2.1: adapt patches and script, use symbolic constants in report descriptor, respond to configuration report ID only, workaround for https://gcc.gn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
    [main.c]
2020-07-16 F303: switch to USB-FS-Device_Lib_V4.1.0: adapt patches and script, use symbolic constants in report descriptor, respond to configuration report ID only, workaround for https://gcc.gnu.org/bugzilla/s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
    [main.c]
2020-07-18 gui: clear debug messages also if device doesn‘t reappear
2020-08-11 verify eeprom writes for reset as well
    [main.c]
2020-11-20 fix duplicate and spelling error
    [main.c]
2021-02-11 test suite and test mode in stm32IRconfig, more protocols
2021-02-16 update prepare.bat‘s (transfer from prepare.sh‘s), adapt to current IRMP/IRSND (#6) (#7)
    * Fix prepare.bat for STM32F103
    * Fix irmp.patch for STM32F103
    * Fix prepare.bat for STM32F105
    * Fix irmp.patch for STM32F105
    * Fix prepare.bat for STM32F303
    * Fix irmp.patch for STM32F303
2021-02-23 add STM32F401, binaries, use ORIGIN() and LENGTH() and comments in linker scripts
2021-04-08 gcc 10 compatibility fix, transfer IR in-/output definitions to F105, fix comments
    [config.h]
2022-01-10 make TARGET more specific, use HID_BUFFER_SIZE and add hid test in stm32IRconfig, add STM32F401xC
2022-01-15 point to @Sl-Alex Mini Board
2022-01-31 add comment on new extension board into Make.config.template
2022-02-09 get tm1637 from own repo, 4-digit-display tm1637 for F303 and F401 as well, fix typo, firmwares
    [main.c]
2022-03-19 improve hid test, print only necessary bytes, sleep longer, transfer linux to Windows, use constants from firmware, minor fixes
    [main.c]
2022-03-19 print only necessary bytes on Windows as well
2022-04-23 invert EXTLED logic, make 4-digit-display conditional, clean up, gui binary
    [config.h, main.c]
2022-04-23 change report count to 64, fix missed copy, firmwares
    [main.c]
2022-07-21 implement eeprom reset and minor fixes
    [main.c]
2022-07-23 align matrix and group box frames
2022-09-01 fix Read(), improve Write(), more thorough compare in Write_and_Check(), cleanup, silence warnings, fix being stuck after IR reception while host not running
    [main.c]
2023-04-08 start STM32F103xC as copy of STM32F103x8
2023-04-08 changes for STM32F103CC (a fake China clone)
2023-04-27 fix USB getting stuck while sending magic on USB FS lib, add eeprom commit, add eeprom get raw
    [main.c]
2023-04-28 firmware for F103CC, set maximum output current for WAKEUP_PIN
2023-05-11 improve detection if host is running for F105, reset PrevXferComplete in Suspend Mode
    [main.c]
2023-05-12 reset PrevXferComplete entering Suspend Mode and remove WKUP_Callback for F103
    [main.c]
2023-05-13 add verify in eeprom_commit(), minor fixes
    [config.h, main.c]
2023-06-03 change wakeup pin, use IRMP's led callback, don't send USB data, if not connected, fix signedness in counter
    [config.h, main.c]
2023-06-14 improve condition for Wakeup() and for USB_HID_SendData(), small fixes and improvements
    [main.c]
2023-06-16 put conditions into function USB_Ready(), small fixes and improvements
    [main.c]
2023-07-07 use PrevXferComplete in RP2040 too, fix handling full in eeprom_begin(), improve eeprom_reset() so eeprom_begin is not needed afterwards
    [main.c]
2023-12-29 reset IRSND_BIT for RP2040
    [irsnd.c]
2023-12-29 reset IRSND_BIT for RP2040, part 2
    [irsnd.c]
2023-12-30 reset IRSND_BIT for RP2040, part 3
    [irsnd.c]
2024-01-11 app for switching statusled on/off
2024-01-14 statusled for F103+F105, fix stm32IRstatusled: -d needs an argument
    [config.h, main.c, st_link_leds.c, st_link_leds.h]
2024-01-18 README for vdr + vdr-plugin-statusleds + stm32IRstatusled, statusled for GreenLink
2024-01-18 change statusled pin for RP2040-One
2024-01-19 pico: show Wakeup on status LED (and store_wakeup, reboot, Reset as well) pico: firmware
    [main.c]
2024-03-27 build for several boards
2024-03-27 use RGB-LED as status LED
2024-04-13 add second neopixel pin for external neopixels
2024-04-17 update READMEs, cleanup Makefiles, improve stm32IRconfig text
2024-04-18 move old stuff, improve stm32IRconfig text
2024-04-20 describe macro configuration with stm32IRconfig_gui, cleanup
2024-09-07 support RP235x, rename RP2040 to RP2xxx because of RP235x, small fixes, cleanup
    [config.h, irmp.c, irmp.h, irmpconfig.h, irmpmain.c, irmpmain.h]
2025-01-22 According to https://forum.seeedstudio.com/t/xiao-rp2350-has-rgb-led-but-is-rgbw-true-in-code/284263 it is RGBW, turn off the power, xiao rp2350 pins, If RGB LED is off during inactivity, stay off al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
2025-01-29 more colors, show USB status via RGB LED, update Windows stm32IRconfig, README+LIESMICH: RGB-LED colors and images, stm32IRconfig binaries, firmware
2025-02-11 fixes for stm32IRconfig, link for Gentoo integration
2025-04-16 turn power for RGB-LED off/on
2025-04-17 led table
2025-04-24 make send_after_wakeup configurable, simplify CMakeLists.txt, README, LIESMICH, ws2812.pio.h might have the wrong pio version, so delete it before building again, firmwares
    [config.h, main.c]
2025-05-21 fix systick clock, firmware
    [main.c]
2025-06-07 don’t filter repeat, let VDR do it
2025-08-05 transmission last macro, when the alarm timer expires
2025-10-07 implement thread to filter out config reports, update LIESMICH and README
2025-11-12 let the LEDs shine during firmware upgrade
2025-12-17 cleanup, comment, add debug to stm32IRconfig
2026-03-05 add repeat rate statistics to irmpconfig, add links to schematics, delay in between sending macros, update IRMP, include IRMP_TECHNICS_PROTOCOL in test-suite, set drive strength of IR_OUT_GPIO to 12 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
2026-03-06 stm32IRconfig Linux and Windows, binaries
2026-07-22 update IRMP, use release detection, fix send magic, don't use board button, fix compilation, cleanup
    [irmp.c, irmp.h, irmpconfig.h, irmpmain.c, irmpmain.h, irsnd.c, main.c]
2026-07-26 STM32F103x8: wait for irwsnd finished, stm32IRconfig: improve monitor, test2
