j1rie/IRMP_STM32/(notices)

Notices in the files:
stm32FWupgrade/Windows/dfu.h:
the Free Software Foundation, either version 3 of the License, or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
